rosam03/AutonomousRobotC/IMG_3995.JPG

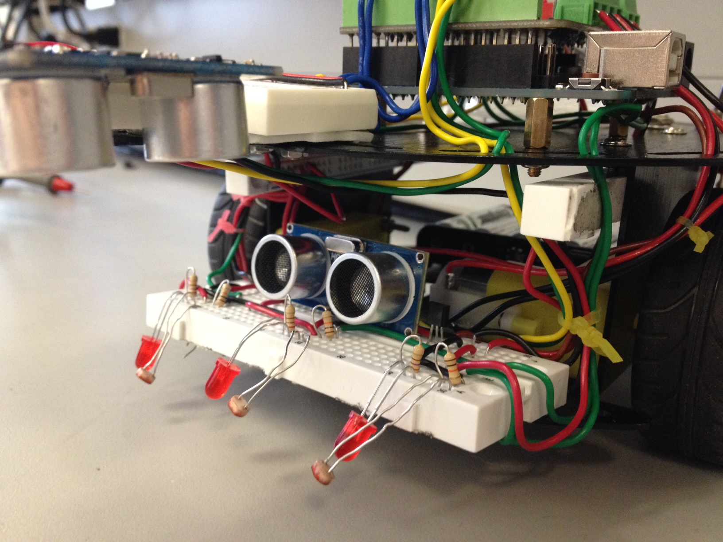
IMG_3995.JPG
