rosam03/AutonomousRobotC/IMG_3993.JPG

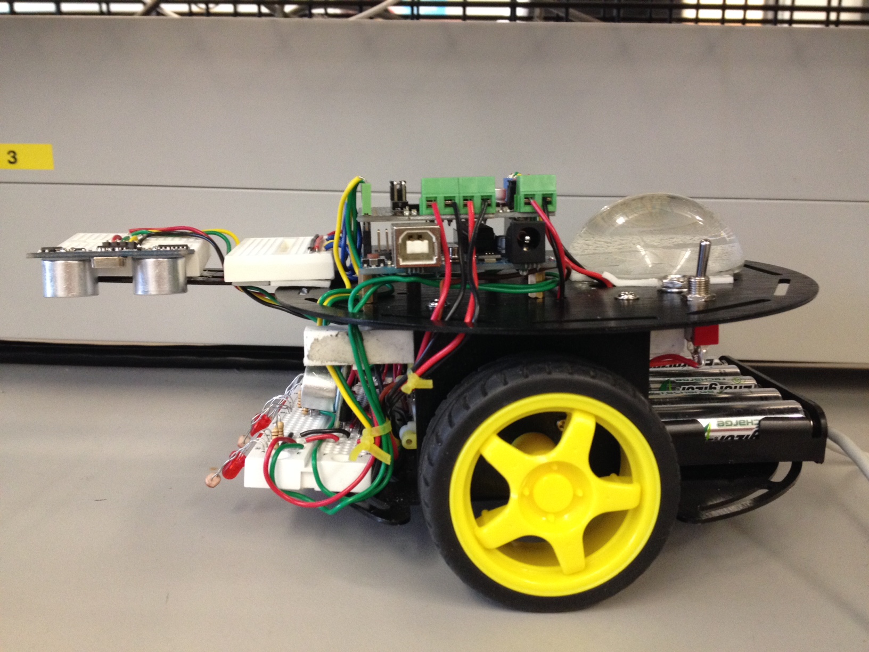
IMG_3993.JPG
