rosam03/AutonomousRobotC/README.md

# AutonomousRobotC

Designed and developed an autonomous robot for a 2nd year team project course.
